supertazon/WiFiflex/KiCad/WifiFlex-connector.kicad_sch

## KiCad design KiCad/WifiFlex-connector.kicad_sch (2024-01-24)

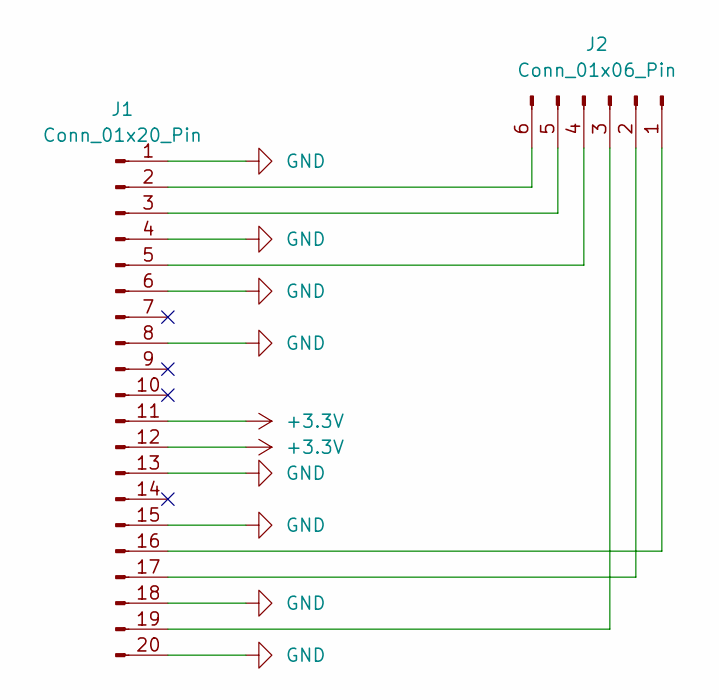
[picture p1: schematic WifiFlex-connector.kicad_sch]

Parts:
J1: Conn_01x20_Pin; Molex_SlimStack_52991-0208_2x10_P0.50mm_Vertical
J2: Conn_01x06_Pin; wififlex

Connections:
+3.3V: J1.11, J1.12
GND: J1.1, J1.4, J1.6, J1.8, J1.13, J1.15, J1.18, J1.20
unnamed: J1.2, J2.6
unnamed: J1.3, J2.5
unnamed: J1.5, J2.4
unnamed: J1.16, J2.1
unnamed: J1.17, J2.2
unnamed: J1.19, J2.3
