supertazon/WiFiflex/(threads)

Thread 2 (2024-01-30):

JLCPCB Manufacturing Restrictions

connorlurring, 2024-01-30:
We have already discussed this in the BitBuilt Discord server but I am posting here as a record that is easier to discover.

JLC are unable to manufacture the V1 board as the tolerance for the castellated holes is not within [their spec](https://jlcpcb.com/capabilities/flex-pcb-capabilities). The hole inner diameter is too small for their process, and the spacing between holes is too small also.
