supertazon/WiFiflex/(commit log)

2024-01-23 Gerbers folder
2024-01-23 Create KiCad folder
2024-01-24 logo proposal
    -logo and silk labels added in 8.0RC1
    [WifiFlex-connector.kicad_pcb]
2024-01-24 Update gerbers
    [WifiFlex-connector.kicad_pcb, WifiFlex-connector.kicad_sch]
