supertazon/WiFiflex/(notices)

Notices in the files:
KiCad/WifiFlex-connector.kicad_sch:
License: MIT
